elhep/MCORD_HUB/Hub_PCB/Boost.PNG

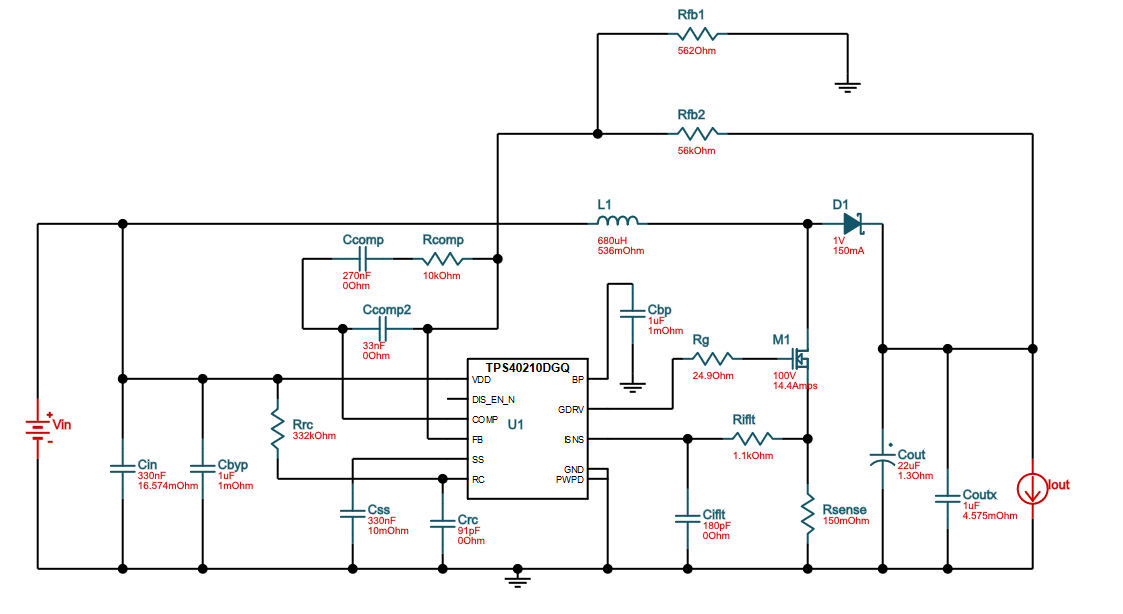
Hub_PCB/Boost.PNG
