elhep/MCORD_HUB/(list of files, drawings)

Other design files:
Hub_PCB/Boost_CNV.SchDoc
Hub_PCB/CPU_STM32F7.SchDoc
Hub_PCB/MCORD_Hub.SchDoc
Hub_PCB/MCORD_Hub_v1.1.PrjPcb
Hub_PCB/PoE.SchDoc
Hub_PCB/RMII_Ethernet.SchDoc
Hub_PCB/SIPM_ASSY_CON.SchDoc
Hub_PCB/USB.SchDoc
