elhep/MCORD_HUB/(threads)

Thread 1 (2019-06-11):

design review

gkasprow, 2019-06-11:
@michalgaska please check
 - [ ]  CPU power supplies
 - [ ] ADC reference
 - [ ] buck converter
 - [ ] I2C devicess addresses (conflicts) c
 - [ ] current measurement range
 - [ ] PoE circuit
 - [ ] 5 and 3.3V buck
 - [ ] LVPECL and analog signal termination
 - [ ] MODBUS and CAN transceivers
 - [ ] Ethernet connection (RGMII, PoE signals)
 - [ ] USB

On PCB:
 - [ ] make sure that fragile analog lines are away from digital ones.

pwkolas, 2020-05-05:
Review of v1.1rc1:

- [ ] Disappeared project file which was available in previous revisions.
- [ ] Just for information purposes. Compared to DevKit (Nucleo), signal RMII_TX_EN connected to the other pin. That is still ok, cause the new pin in the alternate mode can work as desired.
- [ ] Regarding signal USB_VDET. In the DevKit and the previous revision, signal USB_VBUS was connected to the CPU pin. Here it is changed to USB_VDET. Was any reason to do that? The pin is 5V tolerant, so that is not a case?

gkasprow, 2020-05-06:
in the previous version the USB_VBUS was not connected.

gkasprow, 2020-05-06:
there was an error. THe USB_VBUS was not pesent on the sheet symbol

gkasprow, 2020-05-06:
I removed R156. And changed this net name to USB_VBUS

gkasprow, 2020-05-06:
I moved TXEN to PG11 to keep compatibility with Nucleo firmware

Thread 2 (2019-07-06):

Mechanical design

gkasprow, 2019-07-06:
The hub design is finalized.
The box was equipped with several diagnostic LEDs. Every AFE channel has 3 LEDS:
- connection OK. It is on after CPU detects valid CAN endpoint.
- 5V rail overcurrent
- 70V overcurrent
Moreover, CAN and RS485 extension connectors were added to support future upgrade.
The Hub is supplied from PoE switch. 30W capability is required. When necessary, 12V supply can be delivered using either CAN or RS485 connectors.
USB is used for STM32 firmware upgrade.

AD render
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

Enclosure front
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

Enclosure back
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

gkasprow, 2019-07-06:
front view render
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

gkasprow, 2019-07-06:
rear side render
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

gkasprow, 2019-07-06:
3D mechanical step file is here:
[MCORD_HUB_ASSY.zip](https://github.com/elhep/MCORD_HUB/files/3364736/MCORD_HUB_ASSY.zip)

Thread 3 (2019-10-15):

errata

gkasprow, 2019-10-15:
- [x] make C5 smaller

gkasprow, 2019-10-19:
- [ ] move the SAS cage by 0.5mm. Now it has a conflict with board edge

gkasprow, 2020-01-21:
- [ ] replace 5V fuse with 0,75A or 1A version. Existing one has 0.6V DC drop

gkasprow, 2020-01-21:
- [ ] add CAN termination

gkasprow, 2020-01-21:
- [ ] USB_VBUS not connected
- [ ] VBUS_DET has wrong divider

gkasprow, 2020-05-02:
- [ ] replace MCU with F767ZI that supports Ethernet

gkasprow, 2020-05-02:
- [ ] increase HV current limit to 10mA

gkasprow, 2020-05-02:
changed also SPI, Ethernet and second CAN pin assignment

Closed 2020-05-02.

Thread 6 (2020-01-21):

D8 has wrong footprint

gkasprow, 2020-01-21:

gkasprow, 2020-01-21:
the same with other CAN TVS

Closed 2020-05-02.

Thread 7 (2020-04-27):

short manual

gkasprow, 2020-04-27:
Ctrl+d - restart script

run regulator
pyb.Pin.cpu.E12.init(pyb.Pin.OUT_PP, pyb.Pin.PULL_NONE)
pyb.Pin.cpu.E12.value(1)

set AFE DAC
afrdrv.SetDac(out1, out2)
afrdrv.SetDac(60, 60)
afrdrv.SetDac(65, 65)

gkasprow, 2020-04-30:
default voltages afedrv.SetDac(52, 51.9)

gkasprow, 2020-05-02:
Ethernet support is documented here
https://github.com/micropython/micropython/pull/4541

Thread 8 (2020-06-10):

v1.1 production issues

gkasprow, 2020-06-10:
bulkhead SMA: RF249BT0050GHDW -> Molex 0732512201
jumper: 1798942 -> 68001-202HLF
680uH 400mA inductor: B82476A1684M000 -> B82476B1684M100

gkasprow, 2020-07-01:
NUP4114UPXV6T1G -> NUP4114UPXV6T2G
R1206_10R_1%_0.25W_200PPM -> R1206_10R_1%_0.25W_100PPM

gkasprow, 2020-07-01:
Currently produced version does not have R12, R13

gkasprow, 2021-02-19:
JTAG connector replaced with M50-3600542

Closed 2021-02-19.

Thread 9 (2020-09-08):

70V boost start time

gkasprow, 2020-09-08:
increase C5 to 2.2uF to make sure the L2 won't saturate during charging the output caps

gkasprow, 2020-09-08:
replace L2 and L5 with DO3340P-684MLB which has Isat = 1A

Closed 2021-02-19.

Thread 10 (2020-11-29):

Ethernet TVS

gkasprow, 2020-11-29:
Replace Ethernet TVS with D1213A-04V-7

gkasprow, 2021-02-03:
or, DRTR5V0U4S-7

Closed 2021-02-03.

Thread 11 (2021-05-27):

v1.1.1 production issues

gkasprow, 2021-05-27:
IC 14 has the wrong footprint. Still possible to solder but would be nice to fix it.
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

gkasprow, 2022-01-11:
Availability issues
AT25SF161-SSHD-B -> SST26VF016B-104V/SN
AUR9705AGD ??

gkasprow, 2022-01-31:
LTC6101HVCCS5#TR  -> LTC6101HVBIS5#TRMPBF, LTC6101HVBCS5#TRMPBF,LTC6101HVCIS5#TRMPBF
EEEHD2A100P -> EDK106M100A9HAA
