elhep/MCORD_HUB/HUB_Firmware/STM32_config.ioc

Mcu.UserName=STM32H743ZITx
PA0-WKUP.Signal=UART4_TX
PA1.Signal=ETH_REF_CLK
PA10.Signal=USB_OTG_FS_ID
PA11.Signal=USB_OTG_FS_DM
PA12.Signal=USB_OTG_FS_DP
PA13.Signal=SYS_JTMS-SWDIO
PA14.Signal=SYS_JTCK-SWCLK
PA15.Signal=SYS_JTDI
PA2.Signal=ETH_MDIO
PA4.Signal=SPI1_NSS
PA5.Signal=SPI1_SCK
PA6.Signal=SPI1_MISO
PA7.Signal=ETH_CRS_DV
PA9.Signal=USB_OTG_FS_VBUS
PB11.Signal=ETH_TX_EN
PB12.Signal=FDCAN2_RX
PB13.Signal=FDCAN2_TX
PB14.Signal=UART4_DE
PB3.Signal=SYS_JTDO-SWO
PB6.Signal=I2C1_SCL
PB7.Signal=I2C1_SDA
PC1.Signal=ETH_MDC
PC11.Signal=UART4_RX
PC4.Signal=ETH_RXD0
PC5.Signal=ETH_RXD1
PD0.Signal=FDCAN1_RX
PD1.Signal=FDCAN1_TX
PD7.Signal=SPI1_MOSI
PE9.Signal=S_TIM1_CH1
PF11.Signal=ADC1_INP2
PF13.Signal=ADC2_INP2
PG12.Signal=ETH_TXD1
PG13.Signal=ETH_TXD0
