elhep/MCORD_HUB/HUB_Firmware/boot.py

# boot.py -- run on boot-up
# can run arbitrary Python, but best to keep it minimal

import machine
import pyb
print("This is MicroPython")
pyb.country('US') # ISO 3166-1 Alpha-2 code, eg US, GB, DE, AU
pyb.main('main.py') # main script to run after this one
pyb.usb_mode('VCP+MSC') # act as a serial and a storage device
#pyb.usb_mode('VCP+HID') # act as a serial device and a mouse
