elhep/MCORD_HUB/(commit log)

2019-05-26 added STM32 option
    [Boost_CNV.SchDoc, CPU_STM32H7.SchDoc, Ethernet_CTRL.SchDoc, MCORD_Hub.PrjPcb, MCORD_Hub.SchDoc, PoE.SchDoc, RMII_Ethernet.SchDoc, SIPM_ASSY_CON.SchDoc]
2020-05-03 fixed all issues. v1.1rc1
    [Boost_CNV.SchDoc, CPU_STM32F7.SchDoc, CPU_STM32H7.SchDoc, MCORD_Hub.PrjPcb, MCORD_Hub.SchDoc, PoE.SchDoc, SIPM_ASSY_CON.SchDoc, USB.SchDoc]
2021-02-19 v1.1.1 rc1
    [Boost_CNV.SchDoc, CPU_STM32F7.SchDoc, MCORD_Hub.SchDoc, MCORD_Hub_v1.1.PrjPcb, PoE.SchDoc, RMII_Ethernet.SchDoc, SIPM_ASSY_CON.SchDoc, USB.SchDoc]
